woyoung1/HVCCPS/App/G474_HVCCPS.ioc

Mcu.UserName=STM32G474CBTx
PA0.GPIO_Label=I_PRI_DC_ADC
PA0.Signal=ADC2_IN1
PA1.GPIO_Label=I_PRI_AC_ADC
PA1.Signal=SharedAnalog_PA1
PA10.Signal=HRTIM1_CHB1
PA11.Signal=HRTIM1_CHB2
PA12.GPIO_Label=LED_B
PA12.Signal=GPIO_Output
PA15.Signal=I2C1_SCL
PA2.GPIO_Label=V_PRI_DC_ADC
PA2.Signal=ADC1_IN3
PA3.GPIO_Label=V_SEC_DC_ADC
PA3.Signal=ADC1_IN4
PA6.GPIO_Label=I_SEC_DC_ADC
PA6.Signal=ADC2_IN3
PA7.GPIO_Label=KEY_B
PA7.Signal=GPIO_Input
PA8.Signal=HRTIM1_CHA1
PA9.Signal=HRTIM1_CHA2
PB0.GPIO_Label=KEY_A
PB0.Signal=GPIO_Input
PB10.Signal=USART3_TX
PB11.Signal=USART3_RX
PB12.GPIO_Label=LED_A
PB12.Signal=GPIO_Output
PB13.GPIO_Label=AUX_12V_ADC
PB13.Signal=ADC3_IN5
PB14.GPIO_Label=AUX_5V_ADC
PB14.Signal=ADC4_IN4
PB15.GPIO_Label=TEMP_ADC
PB15.Signal=ADC4_IN5
PB7.Signal=I2C1_SDA
PC13.GPIO_Label=LED_C
PC13.Signal=GPIO_Output
PF0-OSC_IN.Signal=RCC_OSC_IN
PF1-OSC_OUT.Signal=RCC_OSC_OUT
