woyoung1/HVCCPS/App/Core/Inc/main.h

#define HRTIM_PRD 15111
#define DEAD_TIME 34
#define LED_C_Pin GPIO_PIN_13
#define LED_C_GPIO_Port GPIOC
#define I_PRI_DC_ADC_Pin GPIO_PIN_0
#define I_PRI_DC_ADC_GPIO_Port GPIOA
#define I_PRI_AC_ADC_Pin GPIO_PIN_1
#define I_PRI_AC_ADC_GPIO_Port GPIOA
#define V_PRI_DC_ADC_Pin GPIO_PIN_2
#define V_PRI_DC_ADC_GPIO_Port GPIOA
#define V_SEC_DC_ADC_Pin GPIO_PIN_3
#define V_SEC_DC_ADC_GPIO_Port GPIOA
#define I_SEC_DC_ADC_Pin GPIO_PIN_6
#define I_SEC_DC_ADC_GPIO_Port GPIOA
#define KEY_B_Pin GPIO_PIN_7
#define KEY_B_GPIO_Port GPIOA
#define KEY_A_Pin GPIO_PIN_0
#define KEY_A_GPIO_Port GPIOB
#define LED_A_Pin GPIO_PIN_12
#define LED_A_GPIO_Port GPIOB
#define AUX_12V_ADC_Pin GPIO_PIN_13
#define AUX_12V_ADC_GPIO_Port GPIOB
#define AUX_5V_ADC_Pin GPIO_PIN_14
#define AUX_5V_ADC_GPIO_Port GPIOB
#define TEMP_ADC_Pin GPIO_PIN_15
#define TEMP_ADC_GPIO_Port GPIOB
#define LED_B_Pin GPIO_PIN_12
#define LED_B_GPIO_Port GPIOA
