woyoung1/HVCCPS/(commit log)

2026-06-21 Add new PCB project file for HVCCPS V1.4 Release
    [BOM.xlsx]
2026-06-21 docs: 添加测试数据输入电流说明
2026-06-21 docs: 更新 README 封面图片并添加 QQ 群信息
2026-06-22 docs: 添加视频教程与测试链接
2026-06-22 docs: 完善烧录与测试说明
2026-06-22 docs: 优化 README 中的项目功能和测试仪器描述格式
2026-06-22 docs: 添加变压器打样后的漏感应和励磁电感信息
2026-06-22 docs: 更新 .gitignore 文件以排除压缩视频文件夹，并添加 Node / HostUI 开发工件的忽略规则 docs: 更新 README 中的图片链接，替换为新的图像源
2026-06-23 docs: 更新 README 中的项目说明视频链接
2026-06-23 docs: 添加整机重量信息到规格表
2026-06-24 fix(hostui): use 1 V voltage setpoint steps
2026-06-24 修改文档
2026-06-24 更新文档
2026-06-25 更新 .gitignore 和 README.md，添加 AGENTS.md 和供电 UVLO/OVP 相关信息
2026-06-25 更新 README.md，移除旧的控制策略框图并添加新的控制策略架构
2026-06-27 在 README.md 中添加 Star History 图表链接
2026-06-27 更新 README.md，添加输出校准步骤及注意事项
2026-07-02 更新 README.md，修正标题格式并明确铜厚描述
2026-07-08 更新 BOM.xlsx 文件，修改物料清单
    [BOM.xlsx]
2026-07-15 Add simulation experiment data files
    - Added 11kHz.png and 45kHz.png for frequency analysis.
    - Included secondary-diode-stress.txt to document diode stress testing via simulation.
    - Added setup.png to provide a visual reference for the experimental setup.
2026-07-15 Add documentation and resources for HVCCPS V1.4
    - Introduced README.md with comprehensive project overview, specifications, architecture, fabrication details, firmware flashing instructions, and testing procedures.
    - Added images for PCB layout, transformer specifications, and assembly examples.
    - Included two new images: stlink-utility.png and transformer-specification.png.
    - Created todo.md for future multilingual support in the host interface and IAP pages.
2026-07-24 docs: sync BOM notes in English README
    [BOM.xlsx]
2026-07-24 docs: clarify BOM source of truth
2026-07-28 feat(telemetry): implement single Y axis calibration and enhance legend interactivity
